lhr-solar/VCAT-RasPi-Breakout/README.md

# Controls-RasPi-Breakout

This is the PCB that will interface with the Raspberry Pi Compute Module 4.
