lhr-solar/VCAT-RasPi-Breakout/3D Models/TL3365AF180QG.stp

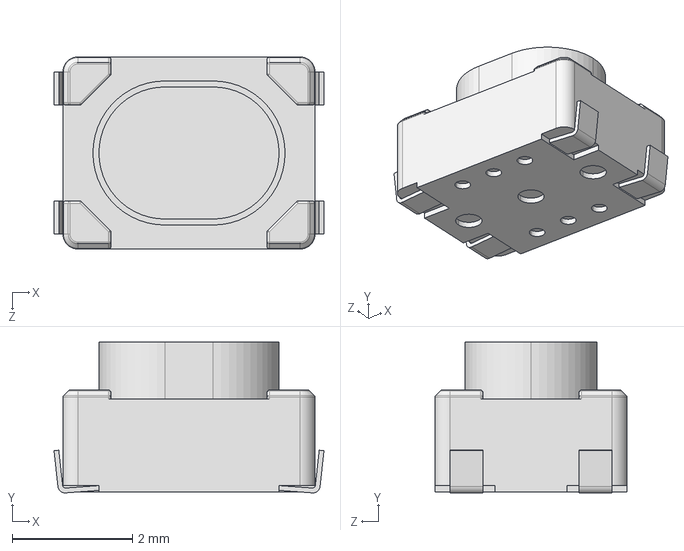
[picture p1: CAD file, 2026-06-18]
3D Models/TL3365AF180QG.stp
4.50 x 2.51 x 3.20 mm
