lhr-solar/VCAT-RasPi-Breakout/PiBoard_Lib/Pi Board Bounds.DXF

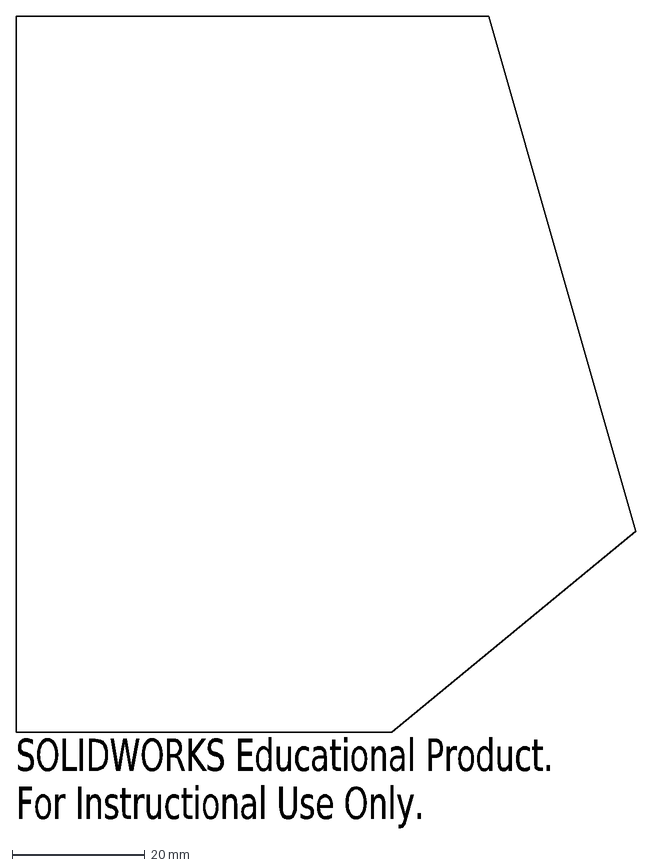
[picture p2: CAD file, 2026-01-18]
PiBoard_Lib/Pi Board Bounds.DXF
SOLIDWORKS Educational Product.
For Instructional Use Only.
