lhr-solar/VCAT-RasPi-Breakout/PiBoard_Lib/SuperCoolPiBounds.DXF

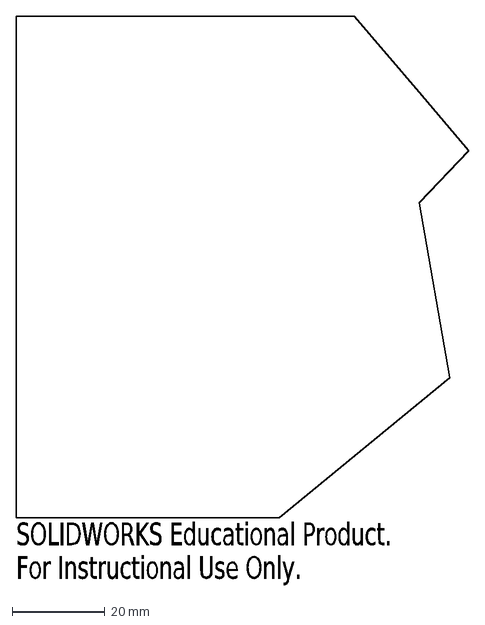
[picture p3: CAD file, 2026-01-18]
PiBoard_Lib/SuperCoolPiBounds.DXF
SOLIDWORKS Educational Product.
For Instructional Use Only.
