lhr-solar/VCAT-RasPi-Breakout/3D Models/USB.stp

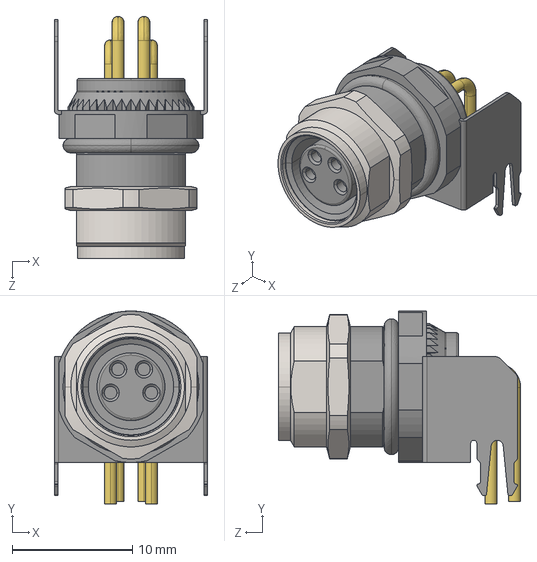
[picture p4: CAD file, 2026-01-18]
3D Models/USB.stp
12.8 x 16.1 x 20.2 mm
