lhr-solar/VCAT-RasPi-Breakout/3D Models/NVMFWS1D7N04XMT1G.stp

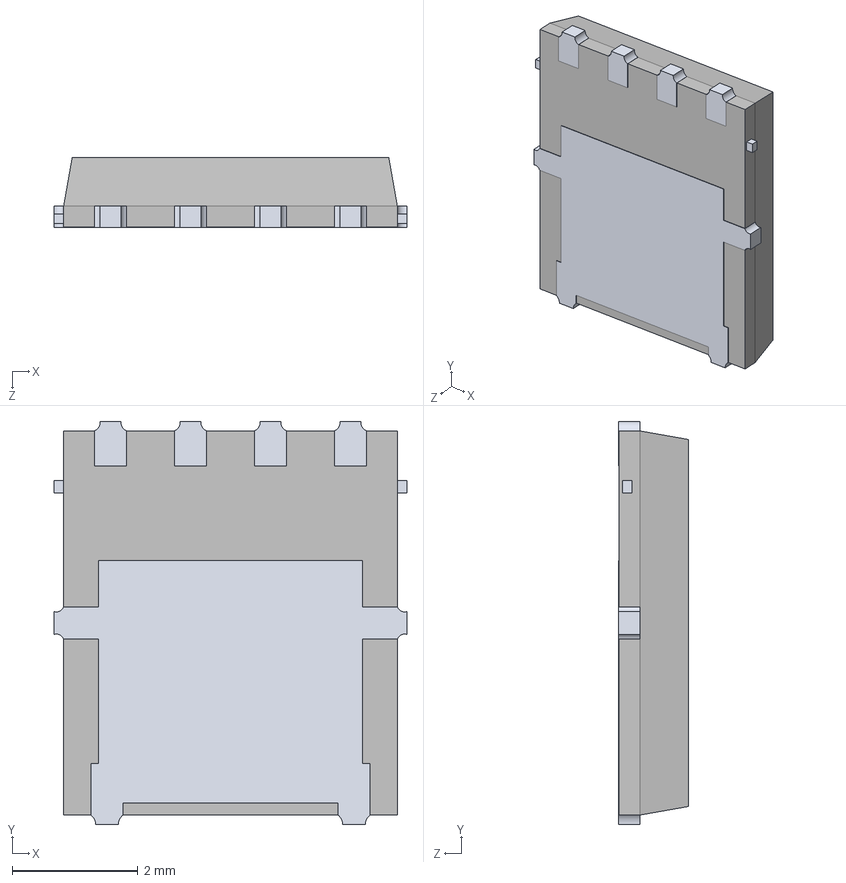
[picture p5: CAD file, 2026-01-18]
3D Models/NVMFWS1D7N04XMT1G.stp
5.60 x 6.40 x 1.11 mm
