lhr-solar/VCAT-RasPi-Breakout/3D Models/CL-SB-22B-12T.stp

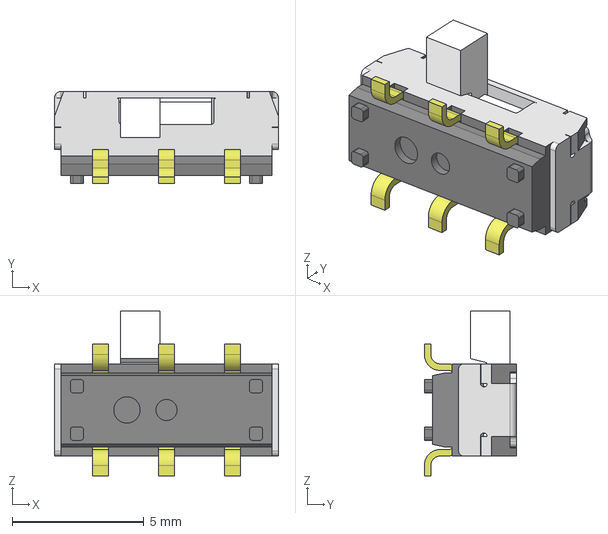
[picture p6: CAD file, 2026-01-18]
3D Models/CL-SB-22B-12T.stp
8.50 x 3.50 x 6.25 mm
22B-12_c
2Side setting_s
