lhr-solar/VCAT-RasPi-Breakout/3D Models/RG9922-111D20-01B0.stp

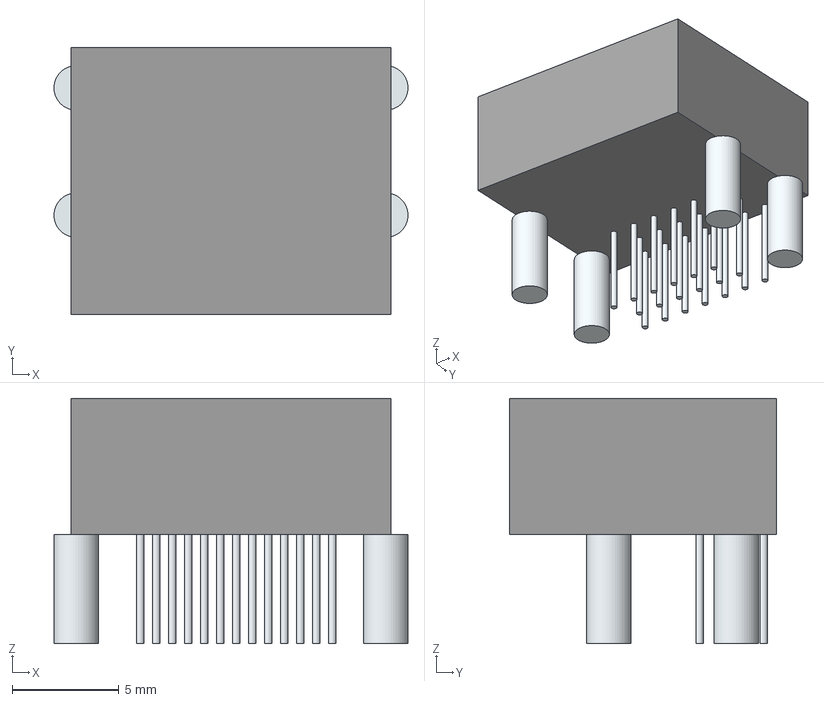
[picture p7: CAD file, 2026-01-18]
3D Models/RG9922-111D20-01B0.stp
16.6 x 12.5 x 11.5 mm
Leads
