lhr-solar/VCAT-RasPi-Breakout/3D Models/CM5-FAN-3007-B-5V 8000 RPM.step

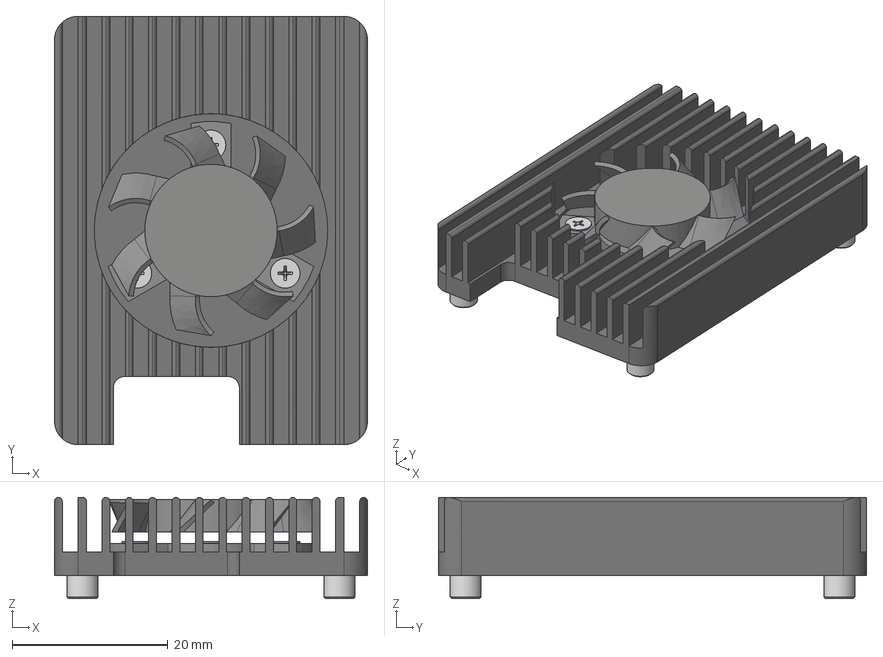
[picture p8: CAD file, 2026-01-18]
3D Models/CM5-FAN-3007-B-5V 8000 RPM.step
40.2 x 55.0 x 13.0 mm
Radiator
Standoff Spacers
Plate
Impeller
DIN EN ISO 7046-2 - M2x4 - H Steel 4.6 Plain x 3
