lhr-solar/VCAT-RasPi-Breakout/3D Models/sot-553.stp

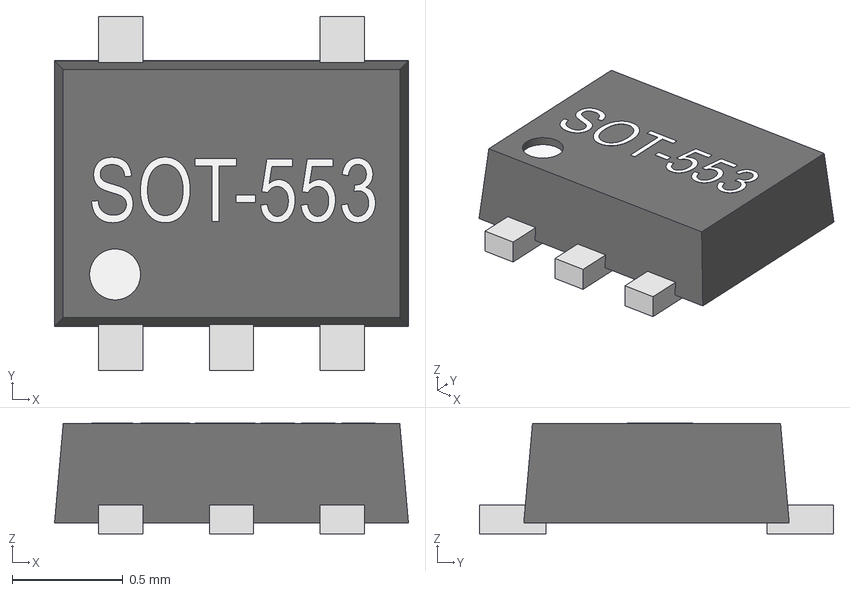
[picture p9: CAD file, 2026-01-18]
3D Models/sot-553.stp
1.60 x 1.60 x 0.501 mm
