lhr-solar/VCAT-RasPi-Breakout/3D Models/B3SL_100[]P.step

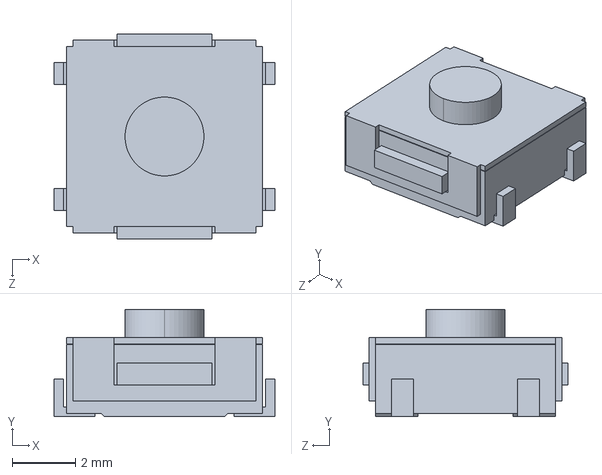
[picture p10: CAD file, 2026-01-18]
3D Models/B3SL_100[]P.step
7.00 x 3.40 x 6.50 mm
