lhr-solar/VCAT-RasPi-Breakout/3D Models/ABM8AIG-25.000MHZ-12-2Z-T3.stp

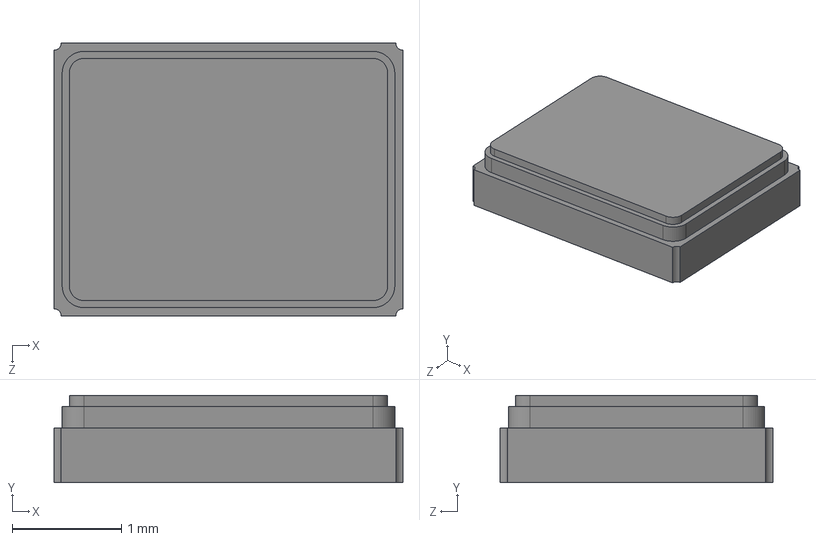
[picture p11: CAD file, 2026-01-18]
3D Models/ABM8AIG-25.000MHZ-12-2Z-T3.stp
3.20 x 0.8 x 2.50 mm
