lhr-solar/VCAT-RasPi-Breakout/3D Models/PAP64_4P15X4P15_TEX.step

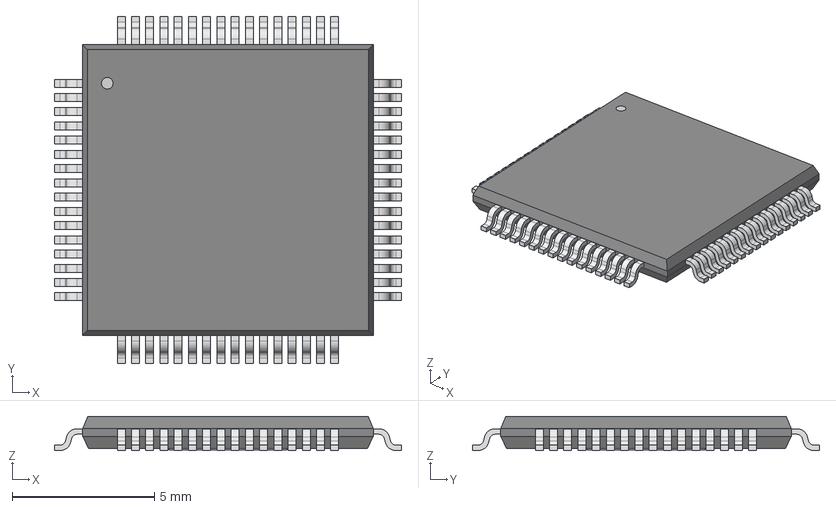
[picture p12: CAD file, 2026-01-18]
3D Models/PAP64_4P15X4P15_TEX.step
12.2 x 12.2 x 1.20 mm
