lhr-solar/VCAT-RasPi-Breakout/3D Models/TPD4E05U06DQAR.STEP

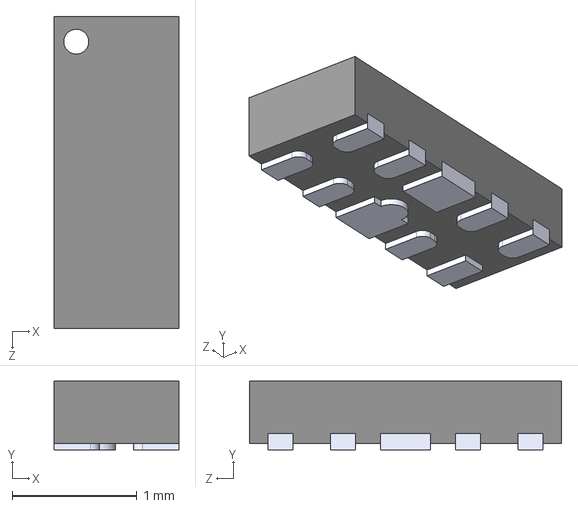
[picture p14: CAD file, 2026-01-18]
3D Models/TPD4E05U06DQAR.STEP
1.00 x 0.55 x 2.50 mm
