lhr-solar/VCAT-RasPi-Breakout/3D Models/ECS-.327-12.5-16-TR.STEP

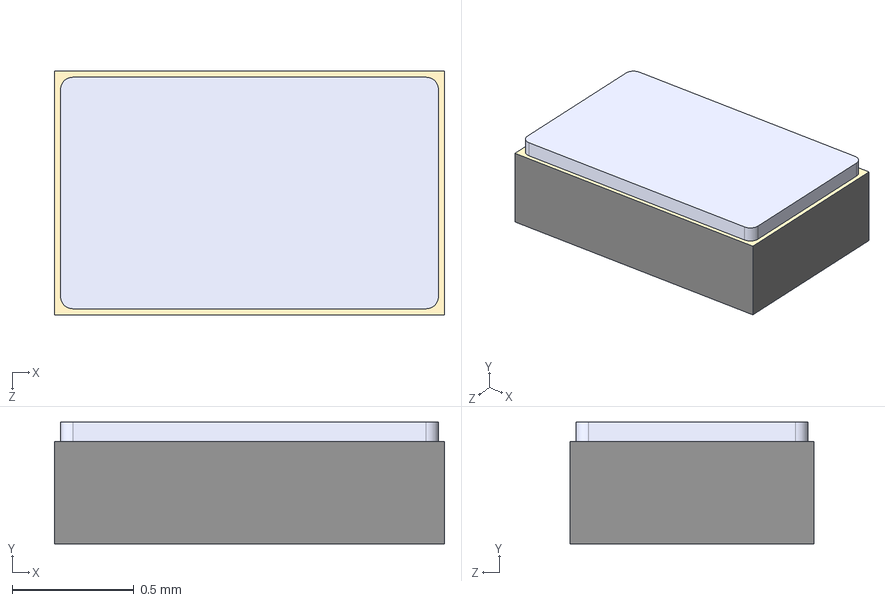
[picture p15: CAD file, 2026-01-18]
3D Models/ECS-.327-12.5-16-TR.STEP
1.60 x 0.5 x 1.00 mm
