lhr-solar/VCAT-RasPi-Breakout/3D Models/SRP1050WA-4R7M.stp

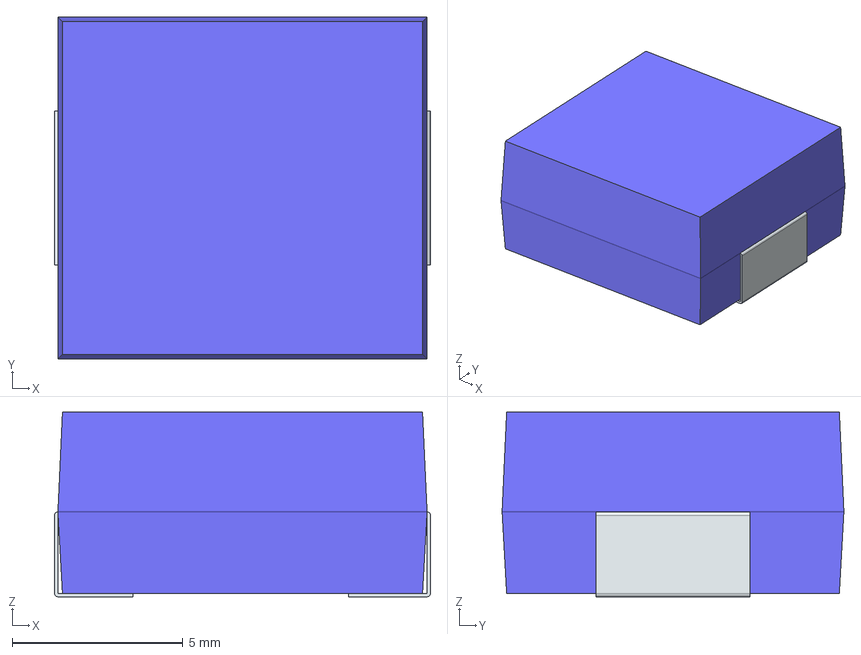
[picture p16: CAD file, 2026-01-18]
3D Models/SRP1050WA-4R7M.stp
11.0 x 10.0 x 5.40 mm
FilletPin1
FilletPin2
