lhr-solar/VCAT-RasPi-Breakout/3D Models/DBV0006A.stp

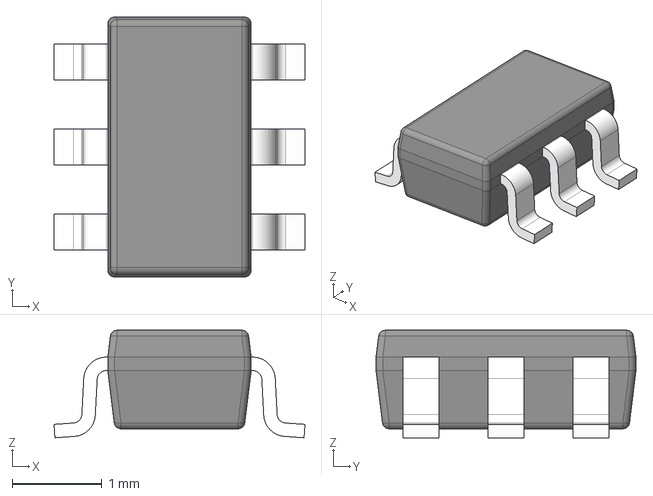
[picture p17: CAD file, 2026-01-18]
3D Models/DBV0006A.stp
2.80 x 2.90 x 1.20 mm
BODY-SOT
LEAD-SOT x 6
