lhr-solar/VCAT-RasPi-Breakout/3D Models/USB4215-03-A.stp

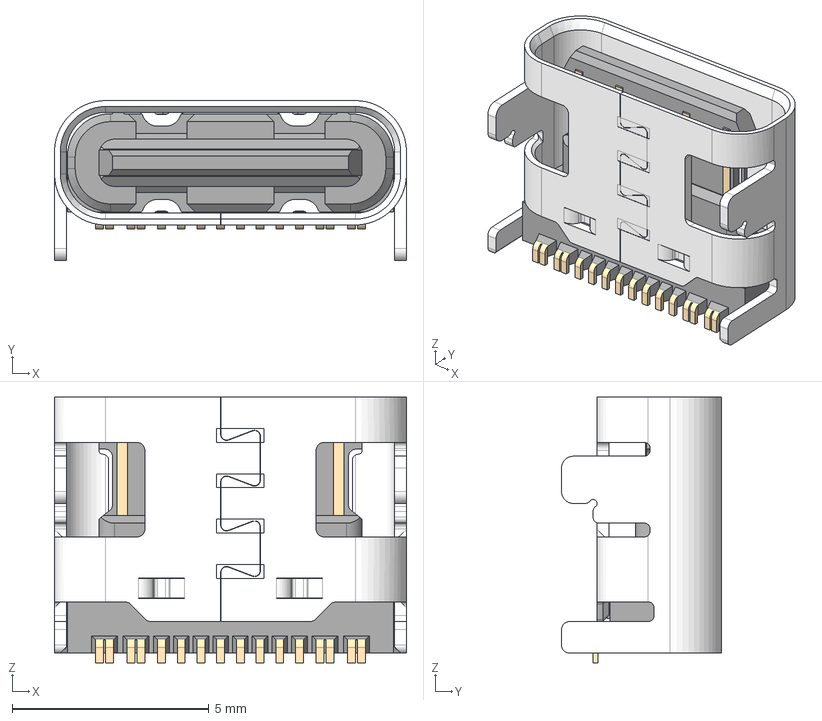
[picture p18: CAD file, 2026-01-18]
3D Models/USB4215-03-A.stp
8.94 x 4.06 x 6.75 mm
USB4215-03-A_PART1
USB4215-03-A_PART2
