lhr-solar/VCAT-RasPi-Breakout/3D Models/ABM3-8.000MHZ-D2Y-T.STEP

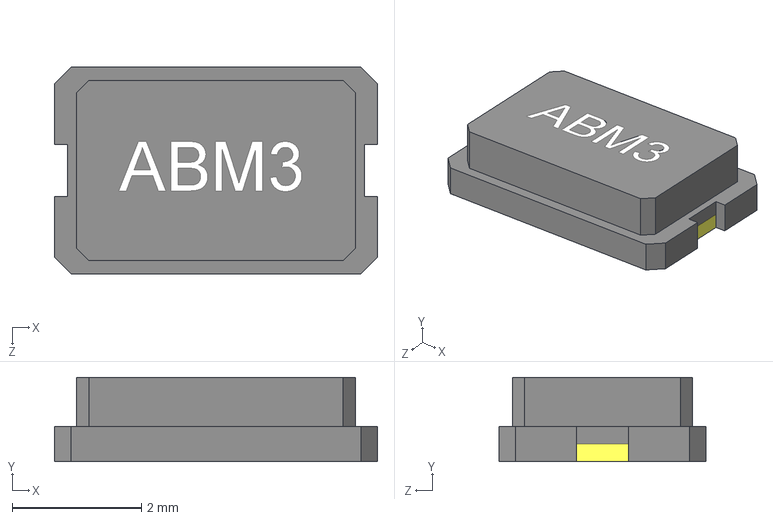
[picture p19: CAD file, 2026-01-18]
3D Models/ABM3-8.000MHZ-D2Y-T.STEP
5.00 x 1.30 x 3.20 mm
