lhr-solar/VCAT-RasPi-Breakout/3D Models/DCN0008A.stp

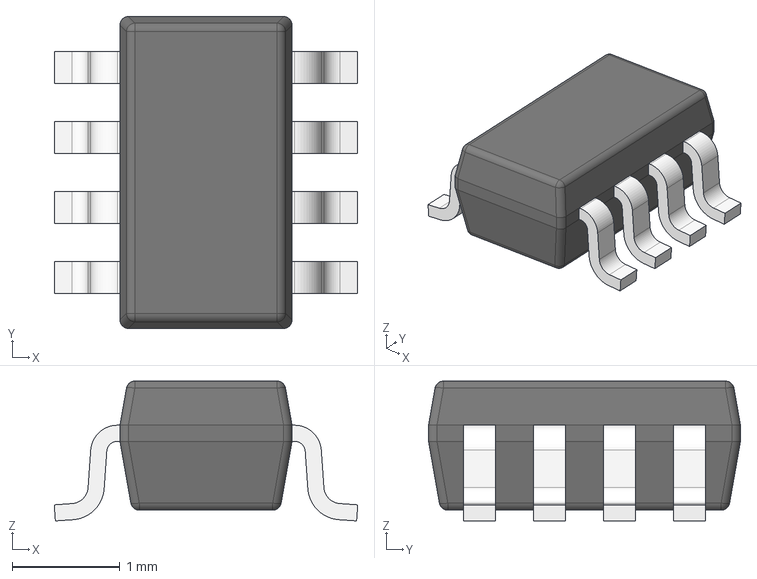
[picture p20: CAD file, 2026-01-18]
3D Models/DCN0008A.stp
2.82 x 2.90 x 1.30 mm
BODY-SO
LEAD-SO x 8
