lhr-solar/VCAT-RasPi-Breakout/3D Models/TPS2557QDRBTQ1.stp

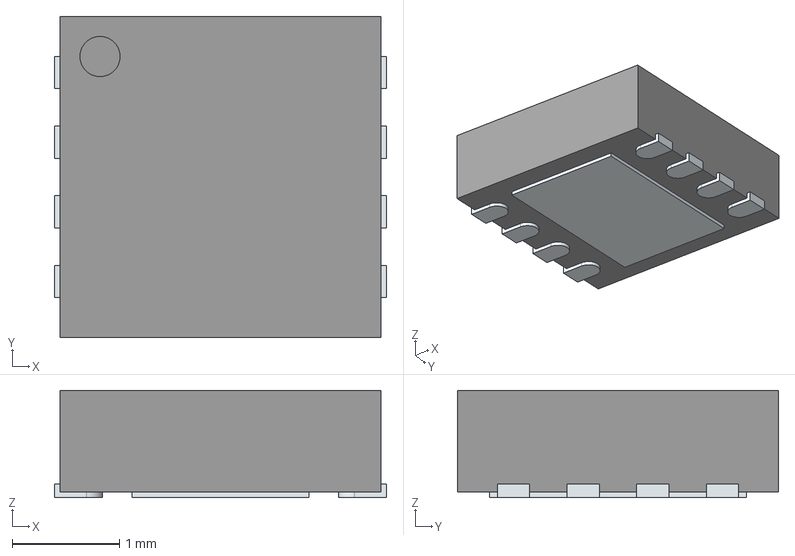
[picture p21: CAD file, 2026-01-18]
3D Models/TPS2557QDRBTQ1.stp
3.10 x 3.00 x 1.00 mm
ThermalPin
PinsArrayLR
