lhr-solar/VCAT-RasPi-Breakout/(list of files, cad)

Other CAD files:
3D Models/ESD204DQAR.STEP
3D Models/0467651001.stp
3D Models/1054500101.stp
3D Models/219320-0001.stp
3D Models/2216080001.stp
3D Models/48405-0003.stp
3D Models/510210200.stp
3D Models/530470210.stp
3D Models/AP64501QSP-13.stp
3D Models/LM73100RPWR.stp
3D Models/LM76202QPWPRQ1.step
3D Models/MX50019NQ1.stp
3D Models/TPS25200DRVR.stp
