lhr-solar/VCAT-RasPi-Breakout/PiBoard.kicad_pcb

## KiCad design PiBoard.kicad_pcb (2026-01-18)

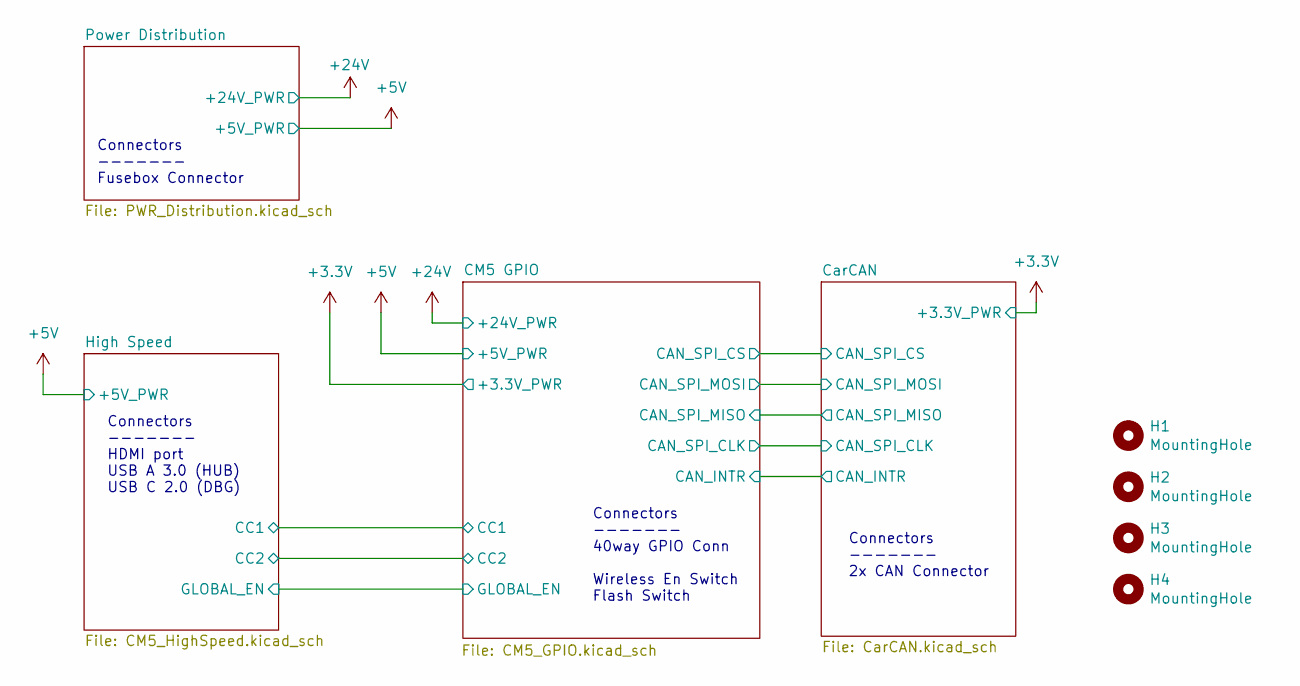
[picture p22: schematic PiBoard.kicad_sch]

Parts:
H1, H2, H3, H4: MountingHole; MountingHole_3.2mm_M3; JLC N/A

Notes on the sheet:
Connectors ------- HDMI port USB A 3.0 (HUB) USB C 2.0 (DBG)
Connectors ------- Fusebox Connector
Connectors ------- 2x CAN Connector
Connectors ------- 40way GPIO Conn Wireless En Switch Flash Switch

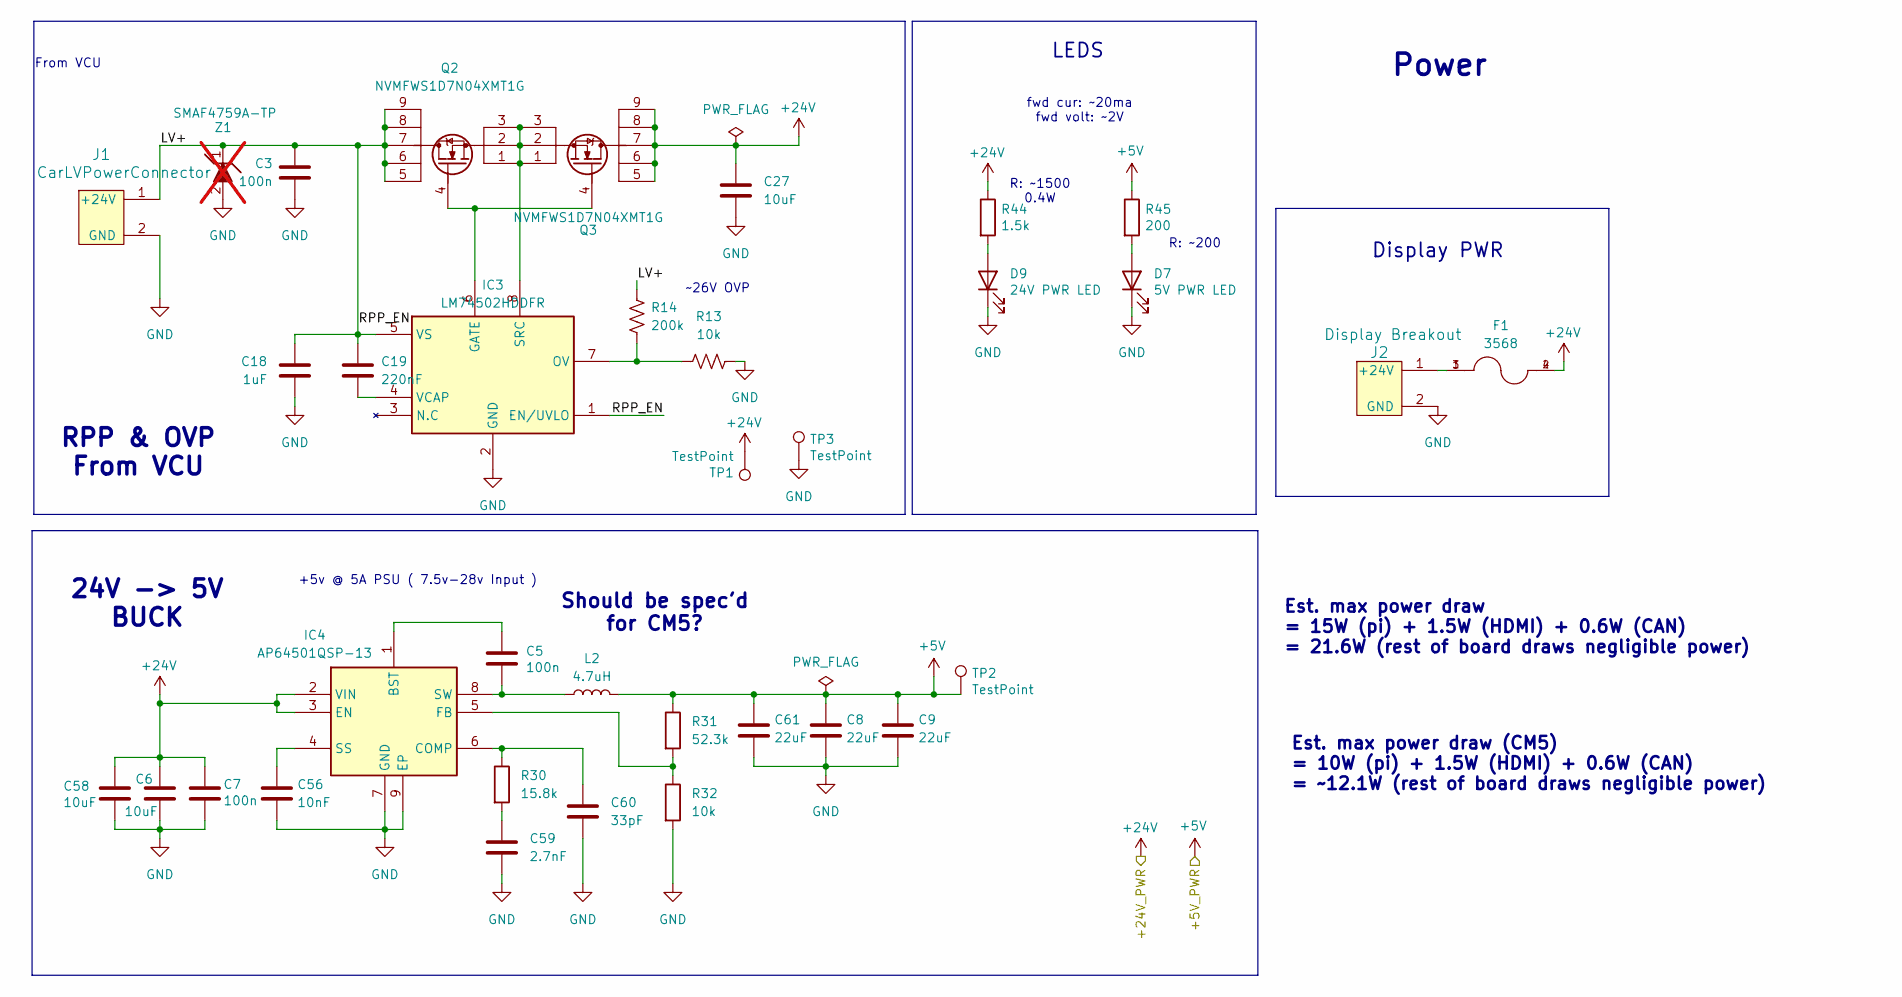
[picture p23: schematic PWR_Distribution.kicad_sch]

Parts:
C3, C5, C7: 100n; C_0603_1608Metric_Pad1.08x0.95mm_HandSolder; JLC C14663
C6, C27, C58: 10uF; C_0805_2012Metric_Pad1.18x1.45mm_HandSolder; JLC C440198
C8, C9, C61: 22uF; C_0805_2012Metric_Pad1.18x1.45mm_HandSolder; JLC C338078
C18: 1uF; C_0805_2012Metric_Pad1.18x1.45mm_HandSolder; JLC C28323
C19: 220nF; C_0805_2012Metric_Pad1.18x1.45mm_HandSolder; JLC C21120
C56: 10nF; C_0603_1608Metric_Pad1.08x0.95mm_HandSolder; JLC C1589
C59: 2.7nF; C_0603_1608Metric_Pad1.08x0.95mm_HandSolder; JLC C107085
C60: 33pF; C_0603_1608Metric_Pad1.08x0.95mm_HandSolder; JLC C1663
D7: 5V PWR LED; LED_0603_1608Metric_Pad1.05x0.95mm_HandSolder; JLC C2289
D9: 24V PWR LED; LED_0603_1608Metric_Pad1.05x0.95mm_HandSolder; JLC C2289
F1: 3568; FUSE_3568; PARTREV C
IC3: LM74502HDDFR; SOT65P280X110-8N; Mouser Part Number 595-LM74502HDDFR
IC4: AP64501QSP-13; SOIC127P600X163-9N; JLC C2071517
J1: CarLVPowerConnector; Molex_Nano-Fit_105309-xx02_1x02_P2.50mm_Vertical; JLC N/A
J2: Display Breakout; Molex_Nano-Fit_105309-xx02_1x02_P2.50mm_Vertical; JLC N/A
L2: 4.7uH; INDPM110100X540N; JLC C19947673
Q2, Q3: NVMFWS1D7N04XMT1G; NVMFWS3D0P04M8LT1G; Manufacturer_Part_Number NVMFWS1D7N04XMT1G; JLC C52190853
R13: 10k; R_0603_1608Metric_Pad0.98x0.95mm_HandSolder; JLC C25804
R14: 200k; R_0603_1608Metric_Pad0.98x0.95mm_HandSolder; JLC C25811
R30: 15.8k; R_0805_2012Metric_Pad1.20x1.40mm_HandSolder; JLC C17468
R31: 52.3k; R_0805_2012Metric_Pad1.20x1.40mm_HandSolder; JLC C22369875
R32: 10k; R_0805_2012Metric; JLC C17414
R44: 1.5k; R_0805_2012Metric_Pad1.20x1.40mm_HandSolder; JLC C417005
R45: 200; R_0603_1608Metric_Pad0.98x0.95mm_HandSolder; JLC C8218
TP1, TP2, TP3: TestPoint; TestPoint_Pad_2.0x2.0mm; JLC N/A
Z1: SMAF4759A-TP; D_SMA; Mouser Part Number 833-SMAF4749A-TP; not fitted

Connections:
+5V: C8.1, C9.1, C61.1, L2.2, R31.1, R45.1, TP2.1; also elsewhere on the board
+24V: C6.1, C7.1, C27.1, C58.1, F1.2, F1.4, IC4.2 (VIN), IC4.3 (EN), Q3.5, Q3.6, Q3.7, Q3.8, Q3.9, R44.1, TP1.1
/Power Distribution/LV+: C3.2, C18.2, C19.1, IC3.1 (EN/UVLO), IC3.5 (VS), J1.1 (+24V), Q2.5, Q2.6, Q2.7, Q2.8, Q2.9, R14.1, Z1.1 (K)
GND: C3.1, C6.2, C7.2, C8.2, C9.2, C18.1, C27.2, C56.2, C58.2, C59.2, C60.2, C61.2, D7.1 (K), D9.1 (K), IC3.2 (GND), IC4.7 (GND), IC4.9 (EP), J1.2 (GND), J2.2 (GND), R13.2, R32.2, TP3.1, Z1.2 (A); also elsewhere on the board
unnamed: C59.1, R30.2
unnamed: D7.2 (A), R45.2
unnamed: D9.2 (A), R44.2
unnamed: IC3.6 (GATE), Q2.4, Q3.4
unnamed: IC3.7 (OV), R13.1, R14.2
unnamed: IC3.8 (SRC), Q2.1, Q2.2, Q2.3, Q3.1, Q3.2, Q3.3
unnamed: C19.2, IC3.4 (VCAP)
unnamed: C5.1, IC4.1 (BST)
unnamed: C60.1, IC4.6 (COMP), R30.1
unnamed: IC4.5 (FB), R31.2, R32.1
unnamed: C56.1, IC4.4 (SS)
unnamed: C5.2, IC4.8 (SW), L2.1
unnamed: F1.1, F1.3, J2.1 (+24V)

Notes on the sheet:
Est. max power draw (CM5) = 10W (pi) + 1.5W (HDMI) + 0.6W (CAN) = ~12.1W (rest of board draws negligible power)
RPP & OVP From VCU
From VCU
Display PWR
Est. max power draw = 15W (pi) + 1.5W (HDMI) + 0.6W (CAN) = 21.6W (rest of board draws negligible power)
R: ~200
Should be spec'd for CM5?
+5v @ 5A PSU ( 7.5v-28v Input )
~26V OVP
R: ~1500 0.4W
LEDS
fwd cur: ~20ma fwd volt: ~2V
Power
24V -> 5V BUCK

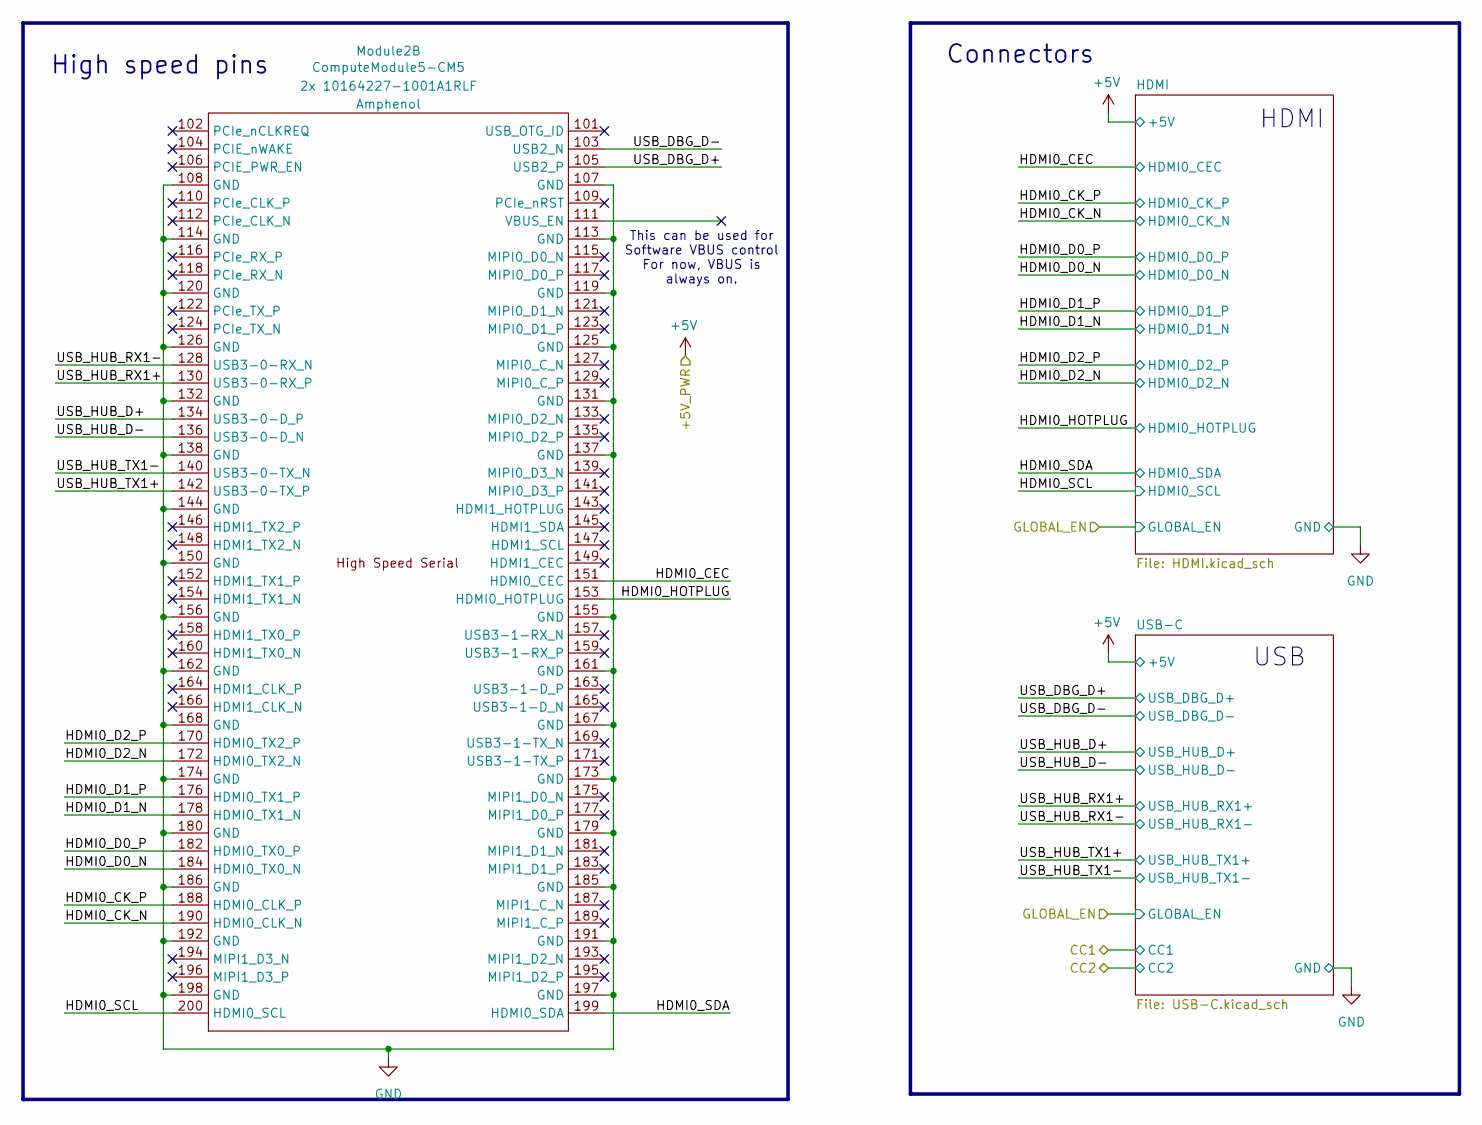
[picture p24: schematic CM5_HighSpeed.kicad_sch]

Parts:
Module2: ComputeModule5-CM5; Raspberry-Pi-5-Compute-Module; Part Description 100 Position Connector Receptacle, Cent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; JLC C6782225

Connections:
/High Speed/HDMI0_CEC: Module2.151 (HDMI0_CEC); also elsewhere on the board
/High Speed/HDMI0_CK_N: Module2.190 (HDMI0_CLK_N); also elsewhere on the board
/High Speed/HDMI0_CK_P: Module2.188 (HDMI0_CLK_P); also elsewhere on the board
/High Speed/HDMI0_D0_N: Module2.184 (HDMI0_TX0_N); also elsewhere on the board
/High Speed/HDMI0_D0_P: Module2.182 (HDMI0_TX0_P); also elsewhere on the board
/High Speed/HDMI0_D1_N: Module2.178 (HDMI0_TX1_N); also elsewhere on the board
/High Speed/HDMI0_D1_P: Module2.176 (HDMI0_TX1_P); also elsewhere on the board
/High Speed/HDMI0_D2_N: Module2.172 (HDMI0_TX2_N); also elsewhere on the board
/High Speed/HDMI0_D2_P: Module2.170 (HDMI0_TX2_P); also elsewhere on the board
/High Speed/HDMI0_HOTPLUG: Module2.153 (HDMI0_HOTPLUG); also elsewhere on the board
/High Speed/HDMI0_SCL: Module2.200 (HDMI0_SCL); also elsewhere on the board
/High Speed/HDMI0_SDA: Module2.199 (HDMI0_SDA); also elsewhere on the board
/High Speed/USB_DBG_D+: Module2.105 (USB2_P); also elsewhere on the board
/High Speed/USB_DBG_D-: Module2.103 (USB2_N); also elsewhere on the board
/High Speed/USB_HUB_D+: Module2.134 (USB3-0-D_P); also elsewhere on the board
/High Speed/USB_HUB_D-: Module2.136 (USB3-0-D_N); also elsewhere on the board
/High Speed/USB_HUB_RX1+: Module2.130 (USB3-0-RX_P); also elsewhere on the board
/High Speed/USB_HUB_RX1-: Module2.128 (USB3-0-RX_N); also elsewhere on the board
/High Speed/USB_HUB_TX1+: Module2.142 (USB3-0-TX_P); also elsewhere on the board
/High Speed/USB_HUB_TX1-: Module2.140 (USB3-0-TX_N); also elsewhere on the board
GND: Module2.107 (GND), Module2.108 (GND), Module2.113 (GND), Module2.114 (GND), Module2.119 (GND), Module2.120 (GND), Module2.125 (GND), Module2.126 (GND), Module2.131 (GND), Module2.132 (GND), Module2.137 (GND), Module2.138 (GND), Module2.144 (GND), Module2.150 (GND), Module2.155 (GND), Module2.156 (GND), Module2.161 (GND), Module2.162 (GND), Module2.167 (GND), Module2.168 (GND), Module2.173 (GND), Module2.174 (GND), Module2.179 (GND), Module2.180 (GND), Module2.185 (GND), Module2.186 (GND), Module2.191 (GND), Module2.192 (GND), Module2.197 (GND), Module2.198 (GND); also elsewhere on the board

Notes on the sheet:
This can be used for Software VBUS control For now, VBUS is always on.
USB
Connectors
High speed pins
HDMI

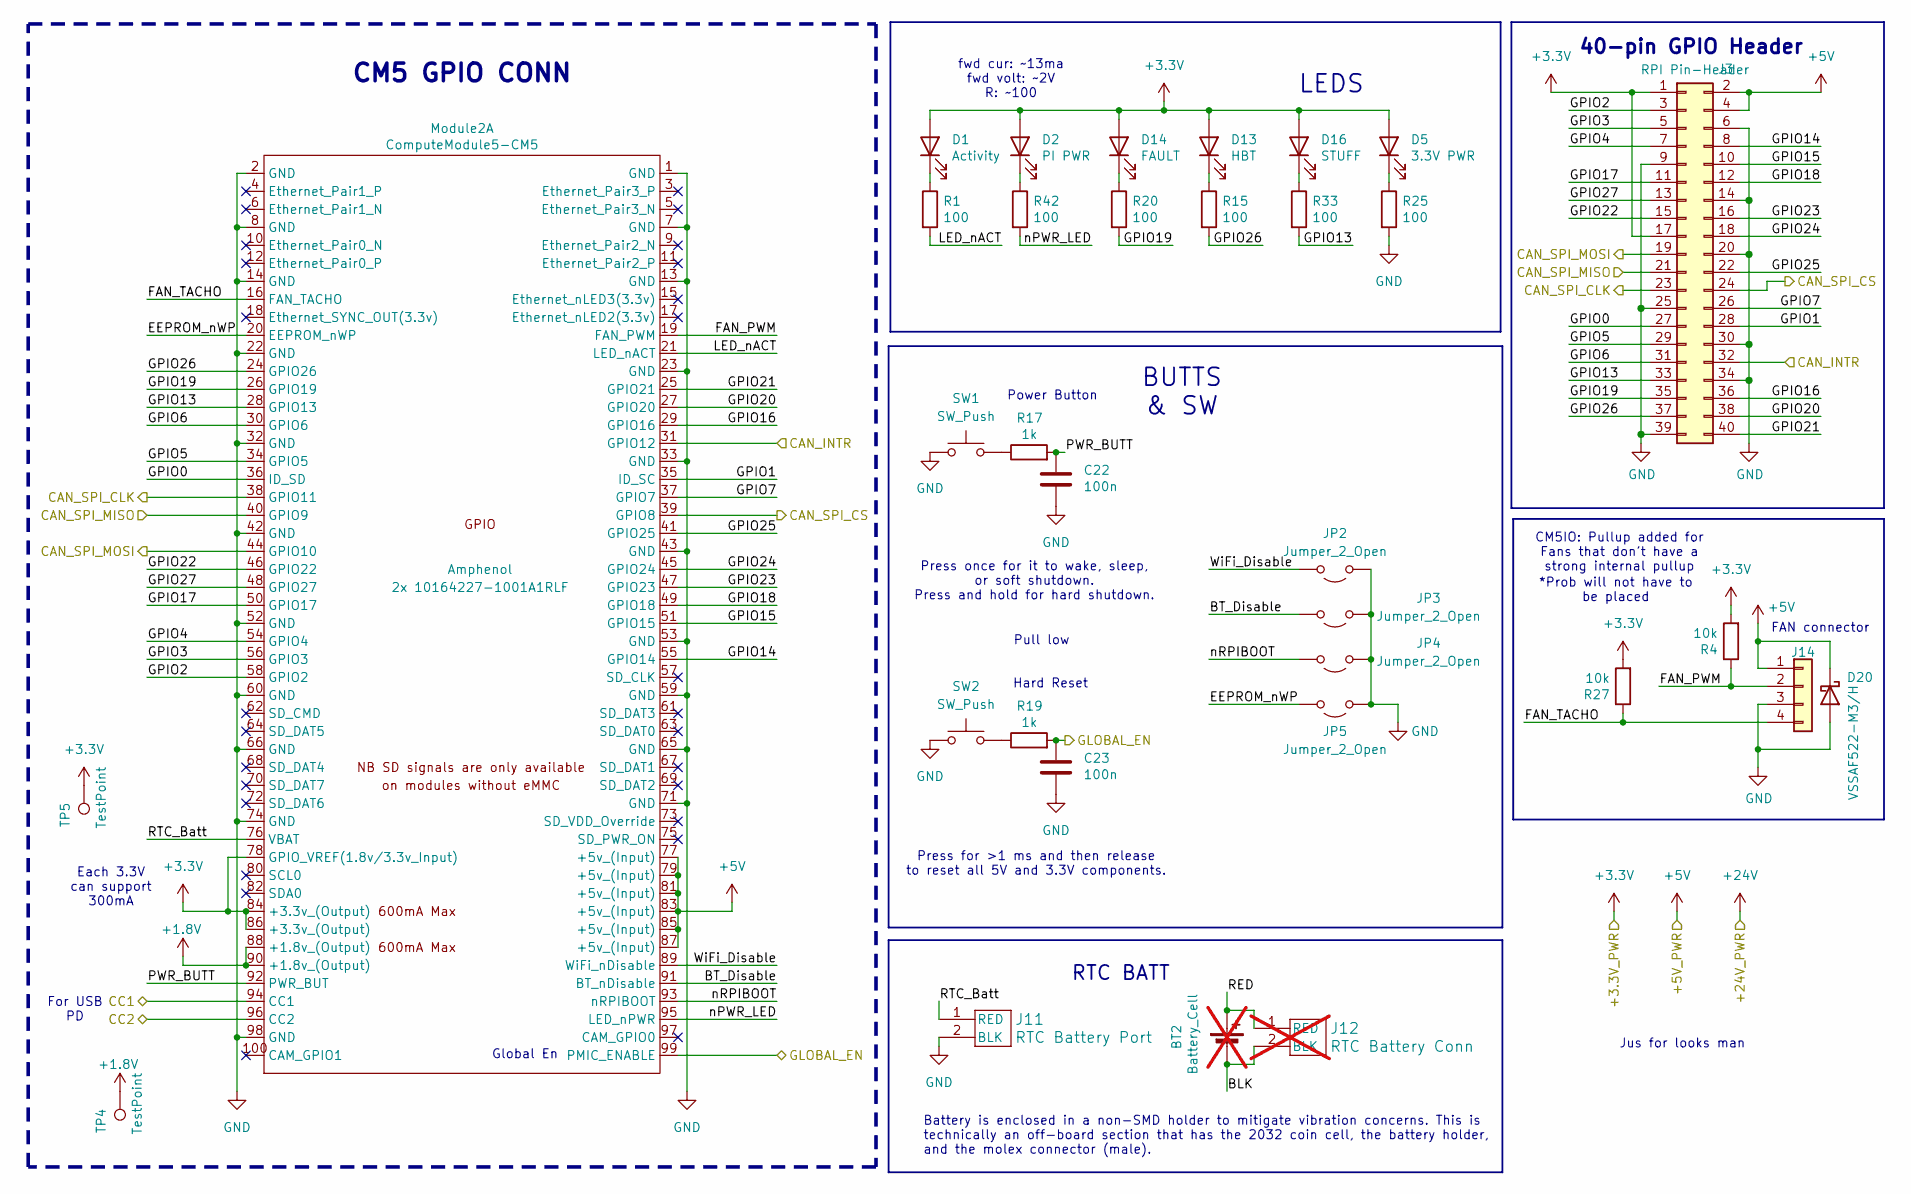
[picture p25: schematic CM5_GPIO.kicad_sch]

Parts:
BT2: Battery_Cell; JLC N/A; not fitted
C22, C23: 100n; C_0603_1608Metric_Pad1.08x0.95mm_HandSolder; JLC C14663
D1: Activity; LED_0603_1608Metric_Pad1.05x0.95mm_HandSolder; JLC C2289
D2: PI PWR; LED_0603_1608Metric_Pad1.05x0.95mm_HandSolder; JLC C2289
D5: 3.3V PWR; LED_0603_1608Metric_Pad1.05x0.95mm_HandSolder; JLC C2289
D13: HBT; LED_0603_1608Metric_Pad1.05x0.95mm_HandSolder; JLC C2289
D14: FAULT; LED_0603_1608Metric_Pad1.05x0.95mm_HandSolder; JLC C2286
D16: STUFF; LED_0603_1608Metric_Pad1.05x0.95mm_HandSolder; JLC C2289
D20: VSSAF522-M3/H; MMDL101T1G; JLC C20039242
J3: RPI Pin-Header; PinSocket_2x20_P2.54mm_Vertical; JLC N/A
J11: RTC Battery Port; CONN02_530470210_MOL; JLC N/A
J12: RTC Battery Conn; CONN02_530470210_MOL; JLC N/A; not fitted
J14: Fan Header; JST_SH_BM04B-SRSS-TB_1x04-1MP_P1.00mm_Vertical; Part Description 4 pin vertical 1mm pitch connector; JLC N/A
JP2, JP3, JP4, JP5: Jumper_2_Open; PinHeader_1x02_P2.54mm_Vertical; JLC N/A
Module2: ComputeModule5-CM5; Raspberry-Pi-5-Compute-Module; Part Description 100 Position Connector Receptacle, Cent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; JLC C6782225
R1, R15, R20, R25, R33, R42: 100; R_0603_1608Metric_Pad0.98x0.95mm_HandSolder; JLC C22775
R4, R27: 10k; R_0603_1608Metric_Pad0.98x0.95mm_HandSolder; Part Description Resistor 10K M1005 1% 63mW; JLC C25804
R17, R19: 1k; R_0603_1608Metric_Pad0.98x0.95mm_HandSolder; JLC C21190
SW1, SW2: SW_Push; SW_SPST_B3SL-1002P; JLC N/A
TP4, TP5: TestPoint; TestPoint_Pad_2.0x2.0mm; JLC N/A

Connections:
+1.8V: Module2.88 (+1.8v_(Output)), Module2.90 (+1.8v_(Output)), TP4.1
+3.3V: D1.2 (A), D2.2 (A), D5.2 (A), D13.2 (A), D14.2 (A), D16.2 (A), J3.1, J3.17, Module2.78 (GPIO_VREF(1.8v/3.3v_Input)), Module2.84 (+3.3v_(Output)), Module2.86 (+3.3v_(Output)), R4.2, R27.2, TP5.1; also elsewhere on the board
+5V: D20.1 (K), J3.2, J3.4, J14.1, Module2.77 (+5v_(Input)), Module2.79 (+5v_(Input)), Module2.81 (+5v_(Input)), Module2.83 (+5v_(Input)), Module2.85 (+5v_(Input)), Module2.87 (+5v_(Input)); also elsewhere on the board
/CM5 GPIO/BT_Disable: JP3.2 (B), Module2.91 (BT_nDisable)
/CM5 GPIO/CAN_INTR: J3.32, Module2.31 (GPIO12); also elsewhere on the board
/CM5 GPIO/CAN_SPI_CLK: J3.23, Module2.38 (GPIO11); also elsewhere on the board
/CM5 GPIO/CAN_SPI_CS: J3.24, Module2.39 (GPIO8); also elsewhere on the board
/CM5 GPIO/CAN_SPI_MISO: J3.21, Module2.40 (GPIO9); also elsewhere on the board
/CM5 GPIO/CAN_SPI_MOSI: J3.19, Module2.44 (GPIO10); also elsewhere on the board
/CM5 GPIO/CC1: Module2.94 (CC1)
/CM5 GPIO/CC2: Module2.96 (CC2)
/CM5 GPIO/EEPROM_nWP: JP5.2 (B), Module2.20 (EEPROM_nWP)
/CM5 GPIO/FAN_PWM: J14.2, Module2.19 (FAN_PWM), R4.1
/CM5 GPIO/FAN_TACHO: J14.4, Module2.16 (FAN_TACHO), R27.1
/CM5 GPIO/GLOBAL_EN: C23.1, Module2.99 (PMIC_ENABLE), R19.2; also elsewhere on the board
/CM5 GPIO/GPIO0: J3.27, Module2.36 (ID_SD)
/CM5 GPIO/GPIO1: J3.28, Module2.35 (ID_SC)
/CM5 GPIO/GPIO2: J3.3, Module2.58 (GPIO2)
/CM5 GPIO/GPIO3: J3.5, Module2.56 (GPIO3)
/CM5 GPIO/GPIO4: J3.7, Module2.54 (GPIO4)
/CM5 GPIO/GPIO5: J3.29, Module2.34 (GPIO5)
/CM5 GPIO/GPIO6: J3.31, Module2.30 (GPIO6)
/CM5 GPIO/GPIO7: J3.26, Module2.37 (GPIO7)
/CM5 GPIO/GPIO13: J3.33, Module2.28 (GPIO13), R33.2
/CM5 GPIO/GPIO14: J3.8, Module2.55 (GPIO14)
/CM5 GPIO/GPIO15: J3.10, Module2.51 (GPIO15)
/CM5 GPIO/GPIO16: J3.36, Module2.29 (GPIO16)
/CM5 GPIO/GPIO17: J3.11, Module2.50 (GPIO17)
/CM5 GPIO/GPIO18: J3.12, Module2.49 (GPIO18)
/CM5 GPIO/GPIO19: J3.35, Module2.26 (GPIO19), R20.2
/CM5 GPIO/GPIO20: J3.38, Module2.27 (GPIO20)
/CM5 GPIO/GPIO21: J3.40, Module2.25 (GPIO21)
/CM5 GPIO/GPIO22: J3.15, Module2.46 (GPIO22)
/CM5 GPIO/GPIO23: J3.16, Module2.47 (GPIO23)
/CM5 GPIO/GPIO24: J3.18, Module2.45 (GPIO24)
/CM5 GPIO/GPIO25: J3.22, Module2.41 (GPIO25)
/CM5 GPIO/GPIO26: J3.37, Module2.24 (GPIO26), R15.2
/CM5 GPIO/GPIO27: J3.13, Module2.48 (GPIO27)
/CM5 GPIO/LED_nACT: Module2.21 (LED_nACT), R1.2
/CM5 GPIO/PWR_BUTT: C22.1, Module2.92 (PWR_BUT), R17.2
/CM5 GPIO/RTC_Batt: J11.1 (RED), Module2.76 (VBAT)
/CM5 GPIO/WiFi_Disable: JP2.2 (B), Module2.89 (WiFi_nDisable)
/CM5 GPIO/nPWR_LED: Module2.95 (LED_nPWR), R42.2
/CM5 GPIO/nRPIBOOT: JP4.2 (B), Module2.93 (nRPIBOOT)
GND: C22.2, C23.2, D20.2 (A), J3.6, J3.9, J3.14, J3.20, J3.25, J3.30, J3.34, J3.39, J11.2 (BLK), J14.3, JP2.1 (A), JP3.1 (A), JP4.1 (A), JP5.1 (A), Module2.1 (GND), Module2.2 (GND), Module2.7 (GND), Module2.8 (GND), Module2.13 (GND), Module2.14 (GND), Module2.22 (GND), Module2.23 (GND), Module2.32 (GND), Module2.33 (GND), Module2.42 (GND), Module2.43 (GND), Module2.52 (GND), Module2.53 (GND), Module2.59 (GND), Module2.60 (GND), Module2.65 (GND), Module2.66 (GND), Module2.71 (GND), Module2.74 (GND), Module2.98 (GND), R25.2, SW1.1, SW2.1; also elsewhere on the board
unnamed: BT2.1 (+), J12.1 (RED)
unnamed: BT2.2 (-), J12.2 (BLK)
unnamed: D1.1 (K), R1.1
unnamed: D2.1 (K), R42.1
unnamed: D5.1 (K), R25.1
unnamed: D13.1 (K), R15.1
unnamed: D14.1 (K), R20.1
unnamed: D16.1 (K), R33.1
unnamed: R17.1, SW1.2
unnamed: R19.1, SW2.2

Notes on the sheet:
Press once for it to wake, sleep, or soft shutdown. Press and hold for hard shutdown.
Power Button
FAN connector
fwd cur: ~13ma fwd volt: ~2V R: ~100
*Prob will not have to be placed
LEDS
Battery is enclosed in a non-SMD holder to mitigate vibration concerns. This is technically an off-board section that has the 2032 coin cell, the battery holder, and the molex connector (male).
Global En
For USB PD
40-pin GPIO Header
Each 3.3V can support 300mA
Jus for looks man
CM5 GPIO CONN
Hard Reset
BUTTS & SW
Press for >1 ms and then release to reset all 5V and 3.3V components.
CM5IO: Pullup added for Fans that don't have a strong internal pullup
Pull low
RTC BATT

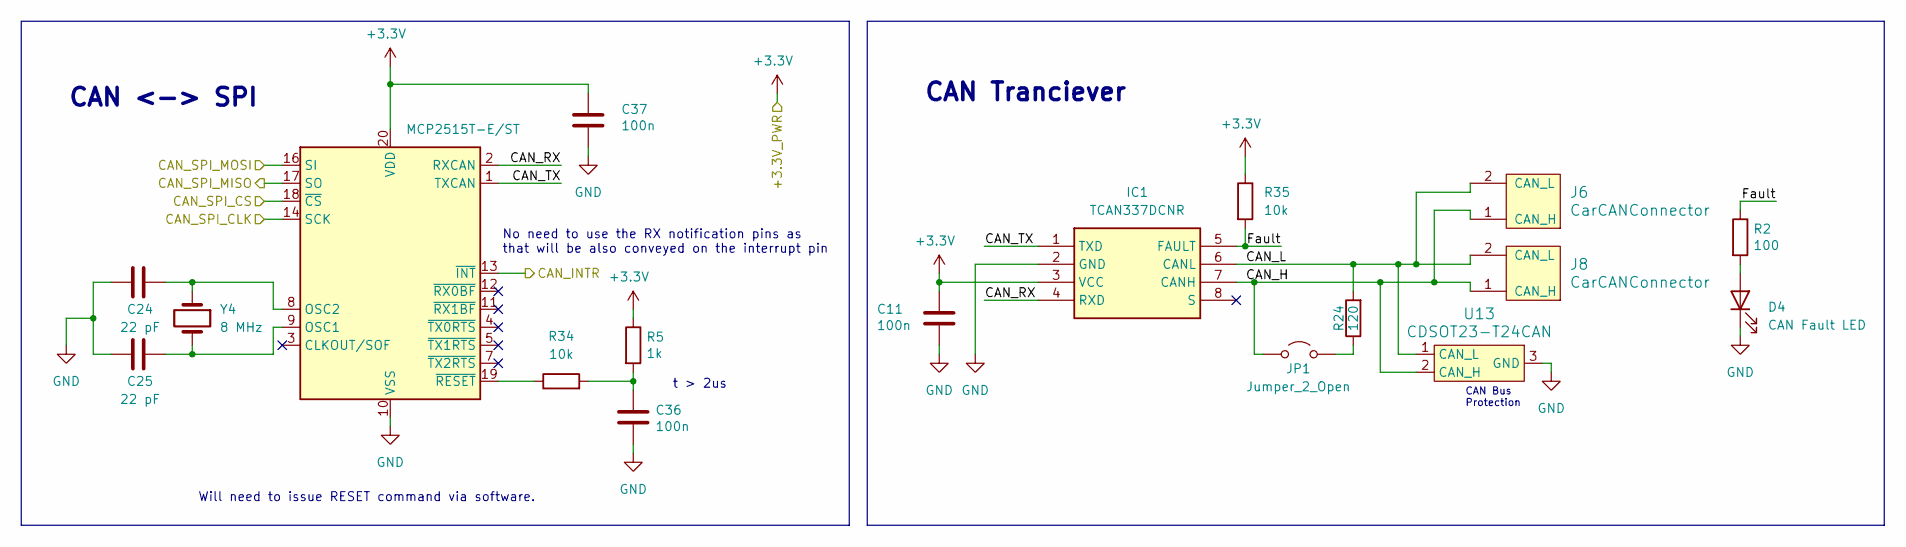
[picture p26: schematic CarCAN.kicad_sch]

Parts:
C11, C36, C37: 100n; C_0603_1608Metric_Pad1.08x0.95mm_HandSolder; JLC C14663
C24, C25: 22 pF; C_0603_1608Metric_Pad1.08x0.95mm_HandSolder; JLC C1653
D4: CAN Fault LED; LED_0603_1608Metric_Pad1.05x0.95mm_HandSolder; JLC C2286
IC1: TCAN337DCNR; SOT65P280X145-8N; JLC C130129
J6, J8: CarCANConnector; Molex_Nano-Fit_105309-xx02_1x02_P2.50mm_Vertical; JLC N/A
JP1: Jumper_2_Open; PinHeader_1x02_P2.54mm_Vertical; JLC N/A
R2: 100; R_0603_1608Metric_Pad0.98x0.95mm_HandSolder; JLC C22775
R5: 1k; R_0603_1608Metric_Pad0.98x0.95mm_HandSolder; JLC C21190
R24: 120; R_0603_1608Metric_Pad0.98x0.95mm_HandSolder; JLC C22787
R34, R35: 10k; R_0603_1608Metric_Pad0.98x0.95mm_HandSolder; JLC C25804
U13: CDSOT23-T24CAN; SOT-23W; JLC C2959841
U14: MCP2515T-E/ST; TSSOP-20_4.4x6.5mm_P0.65mm; JLC C627064
Y4: 8 MHz; ABM3; JLC C144380

Connections:
+3.3V: C11.1, C37.1, IC1.3 (VCC), R5.1, R35.1, U14.20 (VDD); also elsewhere on the board
/CM5 GPIO/CAN_INTR: U14.13 (~INT); also elsewhere on the board
/CM5 GPIO/CAN_SPI_CLK: U14.14 (SCK); also elsewhere on the board
/CM5 GPIO/CAN_SPI_CS: U14.18 (~CS); also elsewhere on the board
/CM5 GPIO/CAN_SPI_MISO: U14.17 (SO); also elsewhere on the board
/CM5 GPIO/CAN_SPI_MOSI: U14.16 (SI); also elsewhere on the board
/CarCAN/CAN_H: IC1.7 (CANH), J6.1 (CAN_H), J8.1 (CAN_H), JP1.1 (A), U13.2 (CAN_H)
/CarCAN/CAN_L: IC1.6 (CANL), J6.2 (CAN_L), J8.2 (CAN_L), R24.2, U13.1 (CAN_L)
/CarCAN/CAN_RX: IC1.4 (RXD), U14.2 (RXCAN)
/CarCAN/CAN_TX: IC1.1 (TXD), U14.1 (TXCAN)
/CarCAN/Fault: IC1.5 (FAULT), R2.1, R35.2
GND: C11.2, C24.1, C25.1, C36.2, C37.2, D4.1 (K), IC1.2 (GND), U13.3 (GND), U14.10 (VSS); also elsewhere on the board
unnamed: C36.1, R5.2, R34.2
unnamed: D4.2 (A), R2.2
unnamed: JP1.2 (B), R24.1
unnamed: C25.2, U14.9 (OSC1), Y4.2
unnamed: C24.2, U14.8 (OSC2), Y4.1
unnamed: R34.1, U14.19 (~RESET)

Notes on the sheet:
CAN Tranciever
t > 2us
No need to use the RX notification pins as that will be also conveyed on the interrupt pin
CAN <-> SPI
CAN Bus Protection
Will need to issue RESET command via software.

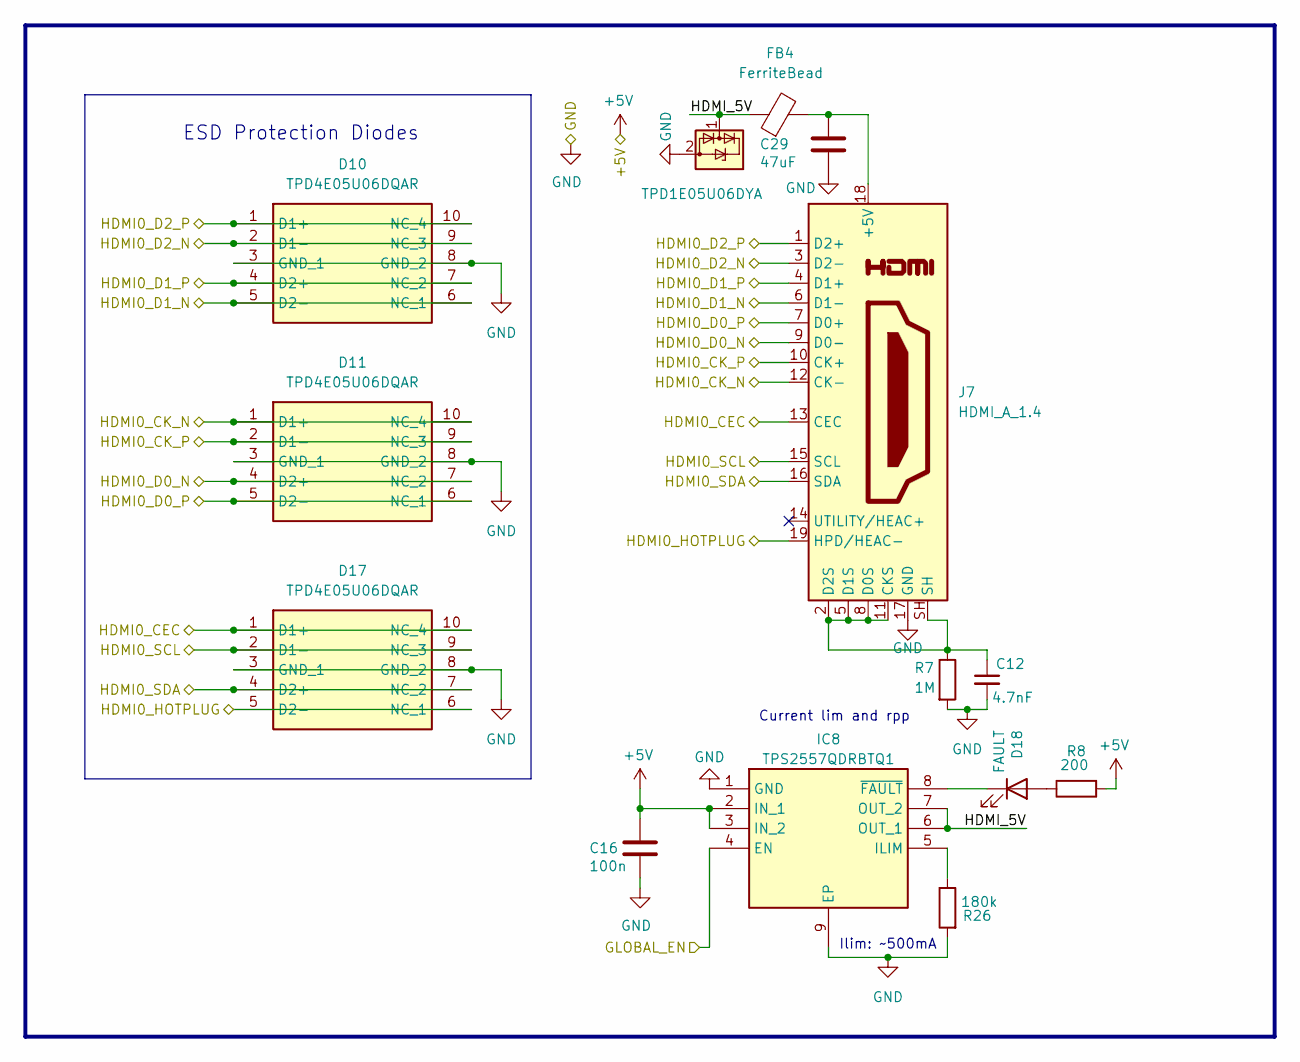
[picture p27: schematic HDMI.kicad_sch]

Parts:
C12: 4.7nF; C_0603_1608Metric_Pad1.08x0.95mm_HandSolder; JLC C696859
C16: 100n; C_0603_1608Metric_Pad1.08x0.95mm_HandSolder; JLC C14663
C29: 47uF; C_0805_2012Metric_Pad1.18x1.45mm_HandSolder; JLC C16780
D10, D11, D17: TPD4E05U06DQAR; IC_TPD4E05U06QDQARQ1; JLC C138714
D18: FAULT; LED_0603_1608Metric_Pad1.05x0.95mm_HandSolder; JLC C2286
FB4: FerriteBead; L_0805_2012Metric_Pad1.05x1.20mm_HandSolder; JLC C1015
IC8: TPS2557QDRBTQ1; SON65P300X300X100-9N-D; Mouser Part Number 595-TPS2557QDRBTQ1
J7: HDMI_A_1.4; HDMI_A_Molex_208658-1001_Horizontal; JLC C916313
R7: 1M; R_0603_1608Metric_Pad0.98x0.95mm_HandSolder; JLC C22935
R8: 200; R_0603_1608Metric_Pad0.98x0.95mm_HandSolder; JLC C8218
R26: 180k; R_0603_1608Metric_Pad0.98x0.95mm_HandSolder; JLC C22356446
U1: TPD1E05U06DYA; D_SOD-523; JLC TPD1E05U06DYAR

Connections:
+5V: C16.1, IC8.2 (IN_1), IC8.3 (IN_2), R8.2; also elsewhere on the board
/CM5 GPIO/GLOBAL_EN: IC8.4 (EN); also elsewhere on the board
/High Speed/HDMI0_CEC: D17.1 (D1+), D17.10 (NC_4), J7.13 (CEC); also elsewhere on the board
/High Speed/HDMI0_CK_N: D11.1 (D1+), D11.10 (NC_4), J7.12 (CK-); also elsewhere on the board
/High Speed/HDMI0_CK_P: D11.2 (D1-), D11.9 (NC_3), J7.10 (CK+); also elsewhere on the board
/High Speed/HDMI0_D0_N: D11.4 (D2+), D11.7 (NC_2), J7.9 (D0-); also elsewhere on the board
/High Speed/HDMI0_D0_P: D11.5 (D2-), D11.6 (NC_1), J7.7 (D0+); also elsewhere on the board
/High Speed/HDMI0_D1_N: D10.5 (D2-), D10.6 (NC_1), J7.6 (D1-); also elsewhere on the board
/High Speed/HDMI0_D1_P: D10.4 (D2+), D10.7 (NC_2), J7.4 (D1+); also elsewhere on the board
/High Speed/HDMI0_D2_N: D10.2 (D1-), D10.9 (NC_3), J7.3 (D2-); also elsewhere on the board
/High Speed/HDMI0_D2_P: D10.1 (D1+), D10.10 (NC_4), J7.1 (D2+); also elsewhere on the board
/High Speed/HDMI0_HOTPLUG: D17.5 (D2-), D17.6 (NC_1), J7.19 (HPD/HEAC-); also elsewhere on the board
/High Speed/HDMI0_SCL: D17.2 (D1-), D17.9 (NC_3), J7.15 (SCL); also elsewhere on the board
/High Speed/HDMI0_SDA: D17.4 (D2+), D17.7 (NC_2), J7.16 (SDA); also elsewhere on the board
/High Speed/HDMI/HDMI_5V: FB4.1, IC8.6 (OUT_1), IC8.7 (OUT_2), U1.1 (I/O)
GND: C12.2, C16.2, C29.2, D10.3 (GND_1), D10.8 (GND_2), D11.3 (GND_1), D11.8 (GND_2), D17.3 (GND_1), D17.8 (GND_2), IC8.1 (GND), IC8.9 (EP), J7.17 (GND), R7.2, R26.2, U1.2 (GND); also elsewhere on the board
unnamed: D18.2 (A), R8.1
unnamed: D18.1 (K), IC8.8 (~FAULT)
unnamed: IC8.5 (ILIM), R26.1
unnamed: C29.1, FB4.2, J7.18 (+5V)
unnamed: C12.1, J7.2 (D2S), J7.5 (D1S), J7.8 (D0S), J7.11 (CKS), J7.SH, R7.1

Notes on the sheet:
Current lim and rpp
ESD Protection Diodes
Ilim: ~500mA

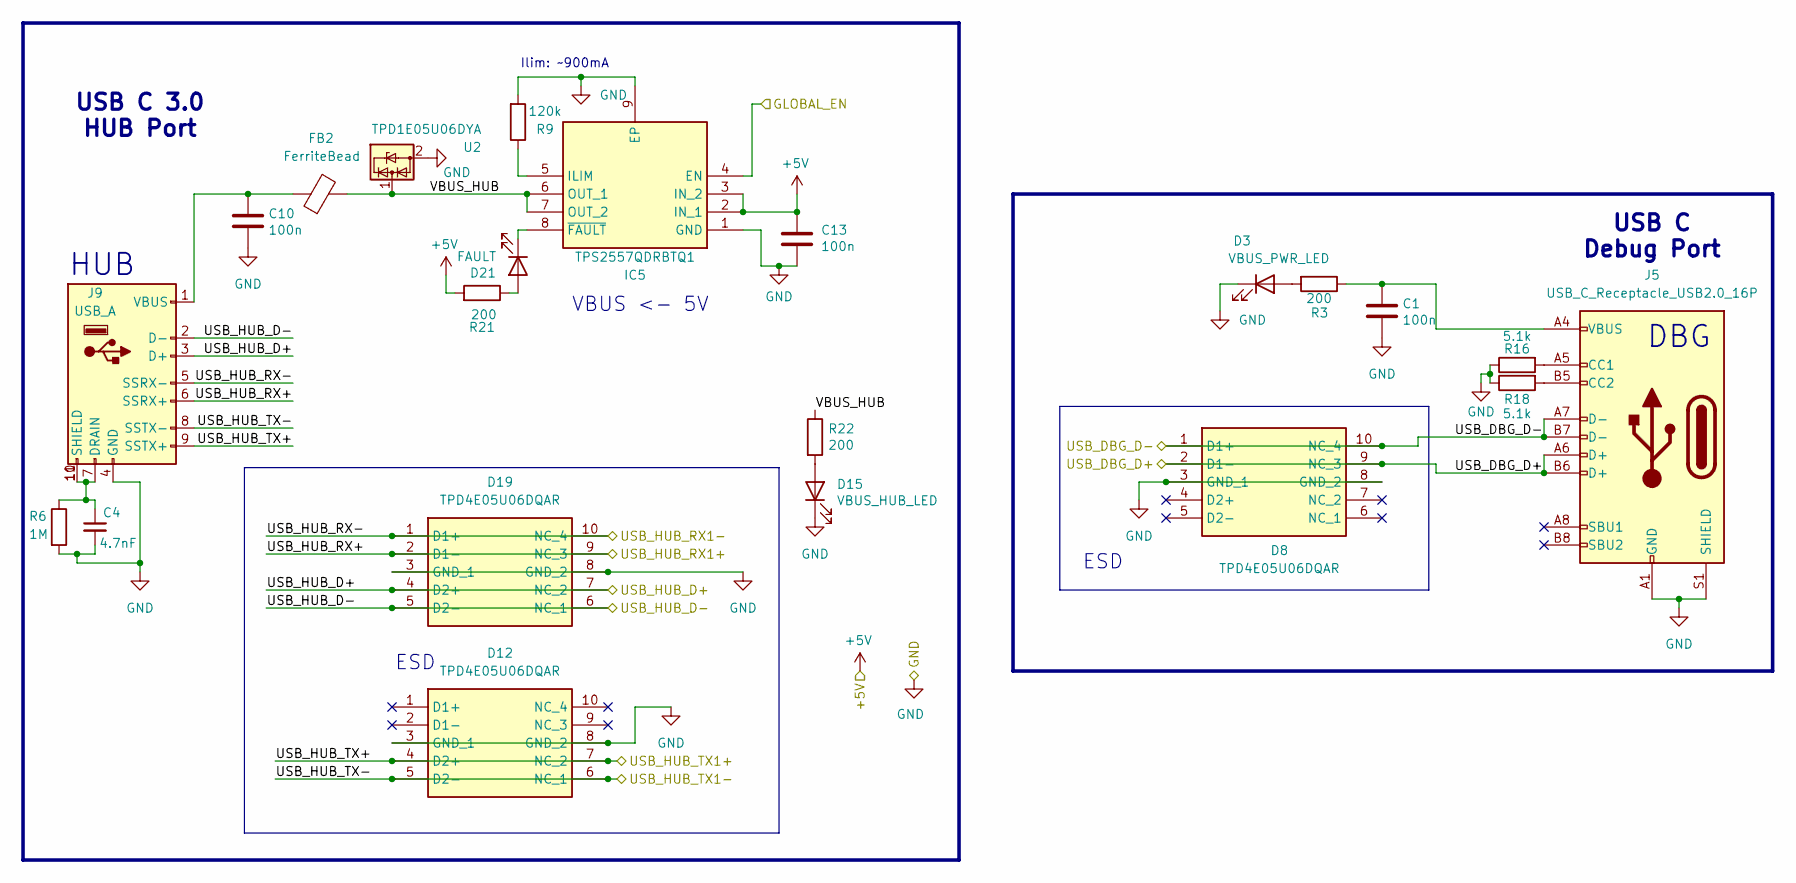
[picture p28: schematic USB-C.kicad_sch]

Parts:
C1, C10, C13: 100n; C_0603_1608Metric_Pad1.08x0.95mm_HandSolder; JLC C14663
C4: 4.7nF; C_0603_1608Metric_Pad1.08x0.95mm_HandSolder; JLC C696859
D3: VBUS_PWR_LED; LED_0603_1608Metric_Pad1.05x0.95mm_HandSolder; JLC C2289
D8, D12, D19: TPD4E05U06DQAR; IC_TPD4E05U06QDQARQ1; JLC C138714
D15: VBUS_HUB_LED; LED_0603_1608Metric_Pad1.05x0.95mm_HandSolder; JLC C2289
D21: FAULT; LED_0603_1608Metric_Pad1.05x0.95mm_HandSolder; JLC C2286
FB2: FerriteBead; L_0805_2012Metric_Pad1.05x1.20mm_HandSolder; JLC C1015
IC5: TPS2557QDRBTQ1; SON65P300X300X100-9N-D; Mouser Part Number 595-TPS2557QDRBTQ1
J5: USB_C_Receptacle_USB2.0_16P; USB_C_Receptacle_GCT_USB4105-xx-A_16P_TopMnt_Horizontal; JLC C37616412
J9: USB_A; CONN_484050003_MOL; JLC C565032
R3, R21, R22: 200; R_0603_1608Metric_Pad0.98x0.95mm_HandSolder; JLC C8218
R6: 1M; R_0603_1608Metric_Pad0.98x0.95mm_HandSolder; JLC C22935
R9: 120k; R_0603_1608Metric_Pad0.98x0.95mm_HandSolder; JLC C25808
R16, R18: 5.1k; R_0603_1608Metric_Pad0.98x0.95mm_HandSolder; JLC C23186
U2: TPD1E05U06DYA; D_SOD-523; JLC TPD1E05U06DYAR

Connections:
+5V: C13.1, IC5.2 (IN_1), IC5.3 (IN_2), R21.2; also elsewhere on the board
/CM5 GPIO/GLOBAL_EN: IC5.4 (EN); also elsewhere on the board
/High Speed/USB-C/VBUS_HUB: FB2.2, IC5.6 (OUT_1), IC5.7 (OUT_2), R22.1, U2.1 (I/O)
/High Speed/USB_DBG_D+: D8.2 (D1-), D8.9 (NC_3), J5.A6 (D+), J5.B6 (D+); also elsewhere on the board
/High Speed/USB_DBG_D-: D8.1 (D1+), D8.10 (NC_4), J5.A7 (D-), J5.B7 (D-); also elsewhere on the board
/High Speed/USB_HUB_D+: D19.4 (D2+), D19.7 (NC_2), J9.3 (D+); also elsewhere on the board
/High Speed/USB_HUB_D-: D19.5 (D2-), D19.6 (NC_1), J9.2 (D-); also elsewhere on the board
/High Speed/USB_HUB_RX1+: D19.2 (D1-), D19.9 (NC_3), J9.6 (SSRX+); also elsewhere on the board
/High Speed/USB_HUB_RX1-: D19.1 (D1+), D19.10 (NC_4), J9.5 (SSRX-); also elsewhere on the board
/High Speed/USB_HUB_TX1+: D12.4 (D2+), D12.7 (NC_2), J9.9 (SSTX+); also elsewhere on the board
/High Speed/USB_HUB_TX1-: D12.5 (D2-), D12.6 (NC_1), J9.8 (SSTX-); also elsewhere on the board
GND: C1.2, C4.2, C10.2, C13.2, D3.1 (K), D8.3 (GND_1), D8.8 (GND_2), D12.3 (GND_1), D12.8 (GND_2), D15.1 (K), D19.3 (GND_1), D19.8 (GND_2), IC5.1 (GND), IC5.9 (EP), J5.A1 (GND), J5.A12 (GND), J5.B1 (GND), J5.B12 (GND), J5.S1 (SHIELD), J9.4 (GND), R6.2, R9.2, R16.1, R18.1, U2.2 (GND); also elsewhere on the board
unnamed: C1.1, J5.A4 (VBUS), J5.A9 (VBUS), J5.B4 (VBUS), J5.B9 (VBUS), R3.1
unnamed: D3.2 (A), R3.2
unnamed: D15.2 (A), R22.2
unnamed: D21.2 (A), R21.1
unnamed: D21.1 (K), IC5.8 (~FAULT)
unnamed: IC5.5 (ILIM), R9.1
unnamed: J5.A5 (CC1), R16.2
unnamed: J5.B5 (CC2), R18.2
unnamed: C4.1, J9.7 (DRAIN), J9.10 (SHIELD), J9.11 (SHIELD), R6.1
unnamed: C10.1, FB2.1, J9.1 (VBUS)

Notes on the sheet:
Ilim: ~900mA
DBG
ESD
HUB
VBUS <- 5V
USB C 3.0 HUB Port
USB C Debug Port
