lhr-solar/VCAT-RasPi-Breakout/PiBoard.kicad_pcb

## KiCad design PiBoard.kicad_pcb (continued)

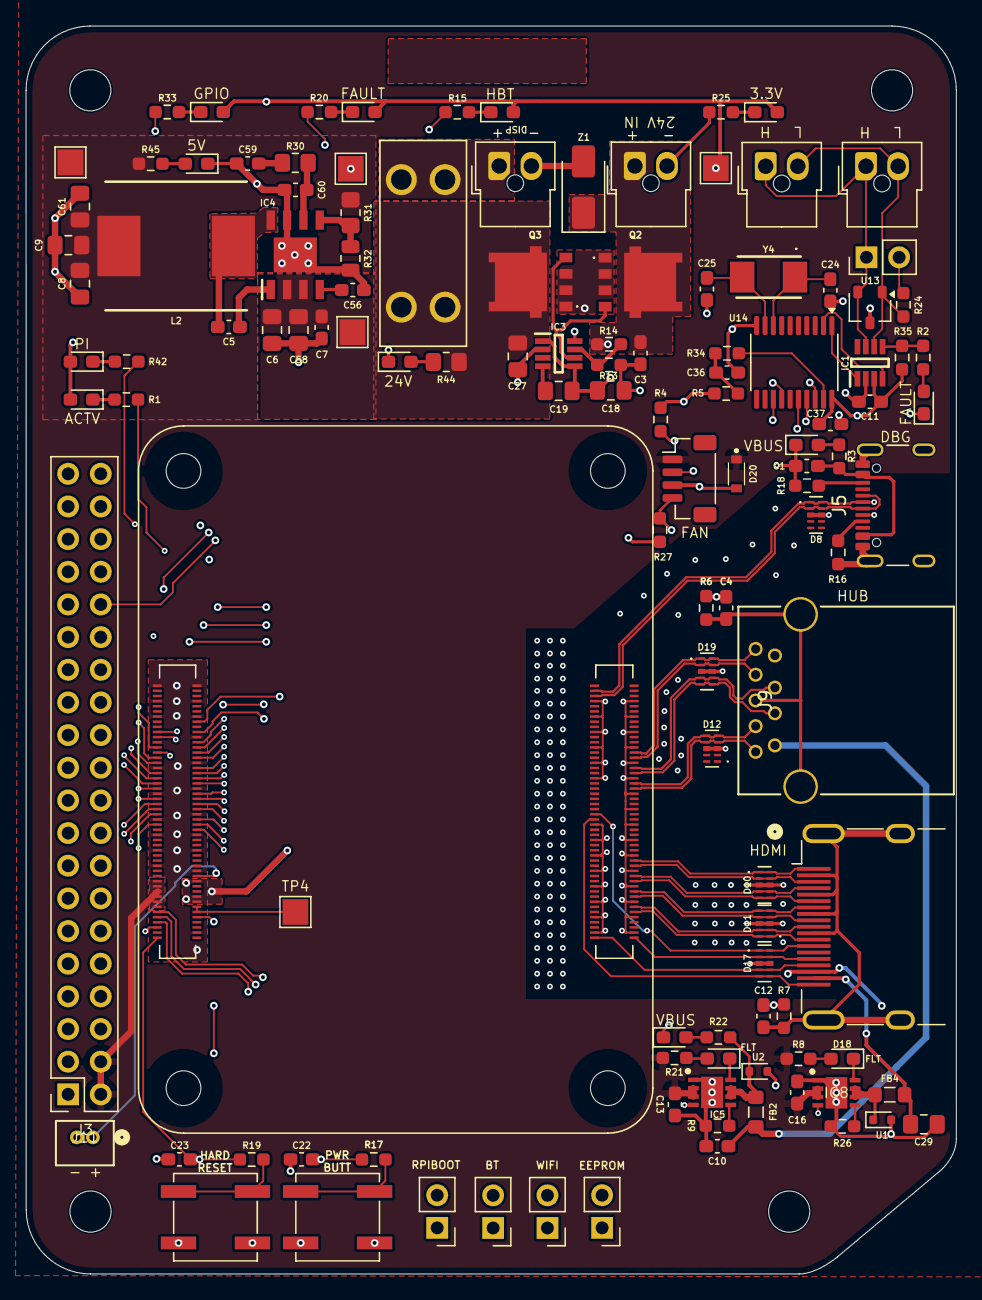
[picture p29: board PiBoard.kicad_pcb from above]

Board: 4 copper layers, 72.3 x 97.1 mm, 124 parts (0 on the bottom side), 114 nets.
