lhr-solar/VCAT-RasPi-Breakout/(commit log)

2025-01-17 think im done with schematic
    [CM4_GPIO.kicad_sch, CarCAN.kicad_sch, HDMI.kicad_sch, PWR_Distribution.kicad_sch, PiBoard.kicad_sch, RTC.kicad_sch, USB_Ports.kicad_sch]
2025-01-17 removed kicad session objects
2026-01-18 Rev A (#1)
    * updated readme
    * small changes for ravi
    * silly mistake
    * some stuff
    * added parts to almost everything (except can xtal and fuses)
    * fixed cap sizes, added remaining parts, fixed rtc battery
    * review committee changes implmented
    * fixed relevant erc errors
    * layout 1.0 kinda done
    * more compact
    * can
    * small notes
    * added 3d models
    * moved some stuff around
    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
    [0467651001.stp, 1054500101.stp, 1x2vert.stp, 219320-0001.stp, 2216080001.stp, 48405-0003.stp, 510210200.stp, 530470210.stp]
2026-06-18 Mika (#2)
    * poop
    * poop
    * poop
    * poop
    * poop
    * ideal diode circuit protection on usbc
    * addressing mika's comments
    * mika changes
    * mika fixes
    * mika changes
    * poop
    * mika changes
    * poop
    * poop
    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
    [CM5_GPIO.kicad_sch, CM5_HighSpeed.kicad_sch, CarCAN.kicad_sch, HDMI.kicad_sch, LM73100RPWR.stp, PWR_Distribution.kicad_sch, PiBoard-BOM-JLC.csv, PiBoard-BOM.csv]
