lhr-solar/VCAT-RasPi-Breakout/(notices)

Notices in the files:
3D Models/USB4215-03-A.stp:
author */ ('License CC BY-ND 4.0'),
